cyrusbuilt/ESPStat/README.md

# ESPStat
ESP8266-controlled thermostat for Heat Pumps
