cyrusbuilt/ESPStat/schematics/ESPStat_bom.html

Label | Part Type | Properties
C1 | Ceramic Capacitor | voltage 6.3V; package 100 mil [THT, multilayer]; capacitance 0.1mF
C2 | Ceramic Capacitor | voltage 6.3V; package 100 mil [THT, multilayer]; capacitance 100nF
DHT1 | DHT22 Humidity and Temperature Sensor
Huzzah ESP8266 | Adafruit HUZZAH ESP8266 | variant variant 2; part # Adafruit #2471
IC1 | ULN2803A | package THT; variant ULN2803A
IC2 | MCP23017 I2C I/O Expander | variant PDIP
J1 | Screw terminal - 6 pins | hole size 1.0mm,0.508mm; package THT; pin spacing 0.137in (3.5mm); pins 6
J2 | Screw terminal - 2 pins | hole size 1.0mm,0.508mm; package THT; pin spacing 0.137in (3.5mm); pins 2
J3 | Generic male header - 3 pins | hole size 1.0mm,0.508mm; row single; package THT; pin spacing 0.1in (2.54mm); pins 3; form ♂ (male)
J4 | Generic male header - 6 pins | hole size 1.0mm,0.508mm; row single; package THT; pin spacing 0.1in (2.54mm); pins 6; form ♂ (male)
LED1 | Green (570nm) LED | package 5 mm [THT]; color Green (570nm); leg yes
LED2 | Green (570nm) LED | package 3 mm [THT]; color Green (570nm); leg yes
LED3 | Green (570nm) LED | package 3 mm [THT]; color Green (570nm); leg yes
LED4 | Green (570nm) LED | package 3 mm [THT]; color Green (570nm); leg yes
LED5 | Green (570nm) LED | package 3 mm [THT]; color Green (570nm); leg yes
LED6 | Red (633nm) LED | package 5 mm [THT]; color Red (633nm); leg yes
LED7 | Red (633nm) LED | package 5 mm [THT]; color Red (633nm); leg yes
LED8 | Red (633nm) LED | package 5 mm [THT]; color Red (633nm); leg yes
LED9 | Yellow (595nm) LED | package 5 mm [THT]; color Yellow (595nm); leg yes
M1 | RioRand LM2596 | chip label lm2596; variant variant 2
Part2 | Schematic Frame | filename ESPStat.fzz; rev 1.0; descr ESP8266-base IoT smart thermostat for heat pumps; sheet 1/1; date 1612884402; project ESPStat
R1 | 10kΩ Resistor | tolerance ±5%; resistance 10kΩ; package THT; bands 4; pin spacing 400 mil
R2 | 150Ω Resistor | tolerance ±5%; resistance 150Ω; package THT; bands 4; pin spacing 400 mil
R3 | 4.7kΩ Resistor | tolerance ±5%; resistance 4.7kΩ; package THT; bands 4; pin spacing 400 mil
REL1 | RELAY | package relay-jzc; variant pth4
REL2 | RELAY | package relay-jzc; variant pth4
REL3 | RELAY | package relay-jzc; variant pth4
REL4 | RELAY | package relay-jzc; variant pth4
Amount | Part Type | Properties
1 | Ceramic Capacitor | voltage 6.3V; package 100 mil [THT, multilayer]; capacitance 0.1mF
1 | Ceramic Capacitor | voltage 6.3V; package 100 mil [THT, multilayer]; capacitance 100nF
1 | DHT22 Humidity and Temperature Sensor
1 | Adafruit HUZZAH ESP8266 | variant variant 2; part # Adafruit #2471
1 | ULN2803A | package THT; variant ULN2803A
1 | MCP23017 I2C I/O Expander | variant PDIP
1 | Screw terminal - 6 pins | hole size 1.0mm,0.508mm; package THT; pin spacing 0.137in (3.5mm); pins 6
1 | Screw terminal - 2 pins | hole size 1.0mm,0.508mm; package THT; pin spacing 0.137in (3.5mm); pins 2
1 | Generic male header - 3 pins | hole size 1.0mm,0.508mm; row single; package THT; pin spacing 0.1in (2.54mm); pins 3; form ♂ (male)
1 | Generic male header - 6 pins | hole size 1.0mm,0.508mm; row single; package THT; pin spacing 0.1in (2.54mm); pins 6; form ♂ (male)
1 | Green (570nm) LED | package 5 mm [THT]; color Green (570nm); leg yes
4 | Green (570nm) LED | package 3 mm [THT]; color Green (570nm); leg yes
3 | Red (633nm) LED | package 5 mm [THT]; color Red (633nm); leg yes
1 | Yellow (595nm) LED | package 5 mm [THT]; color Yellow (595nm); leg yes
1 | RioRand LM2596 | chip label lm2596; variant variant 2
1 | Schematic Frame | filename ESPStat.fzz; rev 1.0; descr ESP8266-base IoT smart thermostat for heat pumps; sheet 1/1; date 1612884402; project ESPStat
1 | 10kΩ Resistor | tolerance ±5%; resistance 10kΩ; package THT; bands 4; pin spacing 400 mil
1 | 150Ω Resistor | tolerance ±5%; resistance 150Ω; package THT; bands 4; pin spacing 400 mil
1 | 4.7kΩ Resistor | tolerance ±5%; resistance 4.7kΩ; package THT; bands 4; pin spacing 400 mil
4 | RELAY | package relay-jzc; variant pth4
