cyrusbuilt/ESPStat/schematics/ESPStat_bb.pdf

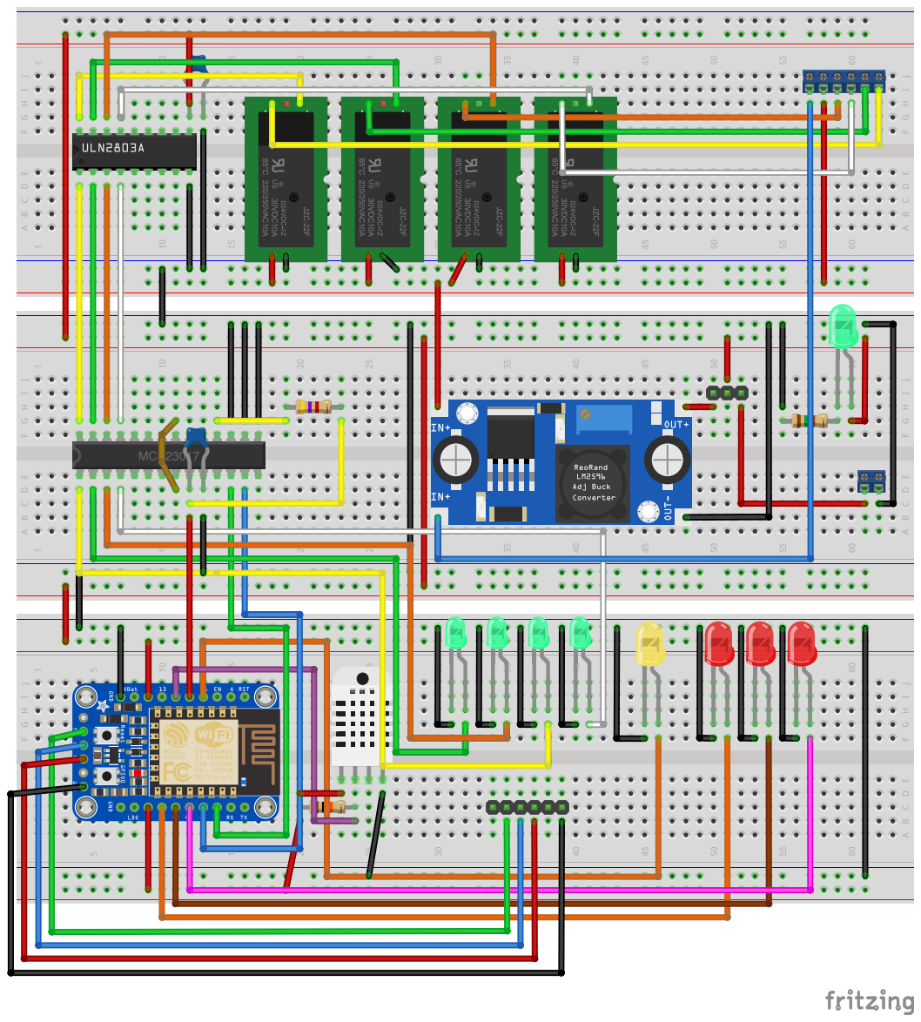
[picture p1: page 1]
