cyrusbuilt/ESPStat/schematics/ESPStat_pcb.pdf

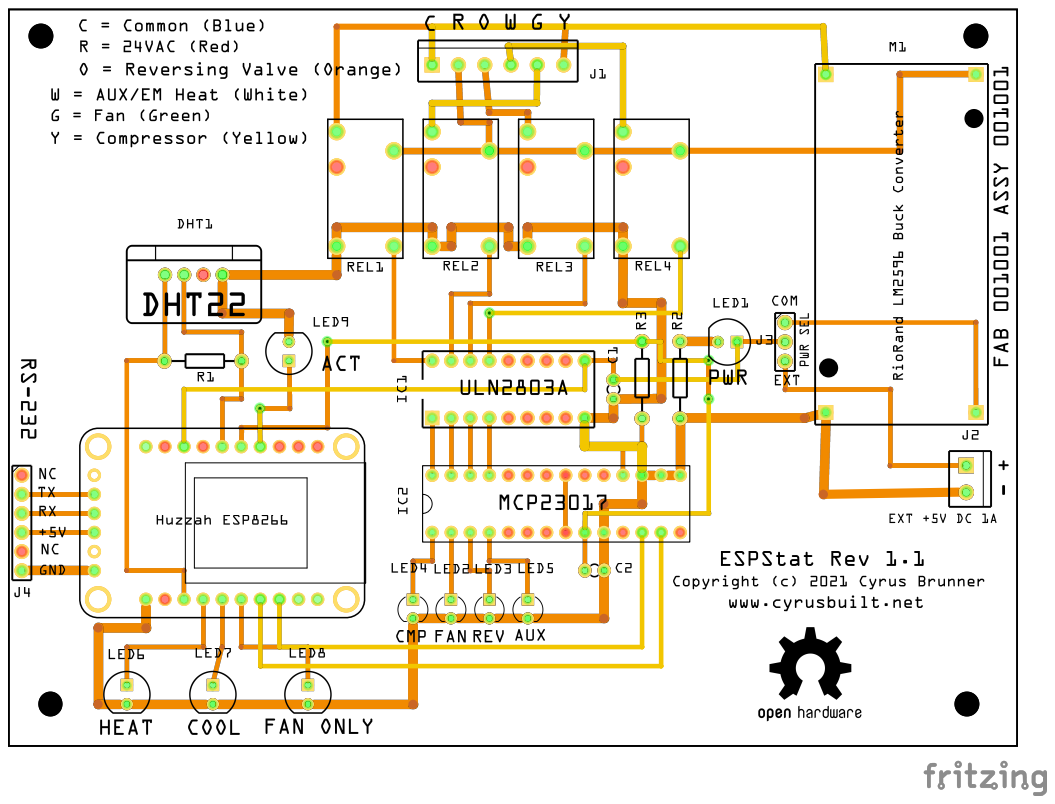
[picture p2: page 1]
