cyrusbuilt/ESPStat/schematics/ESPStat_schem.pdf

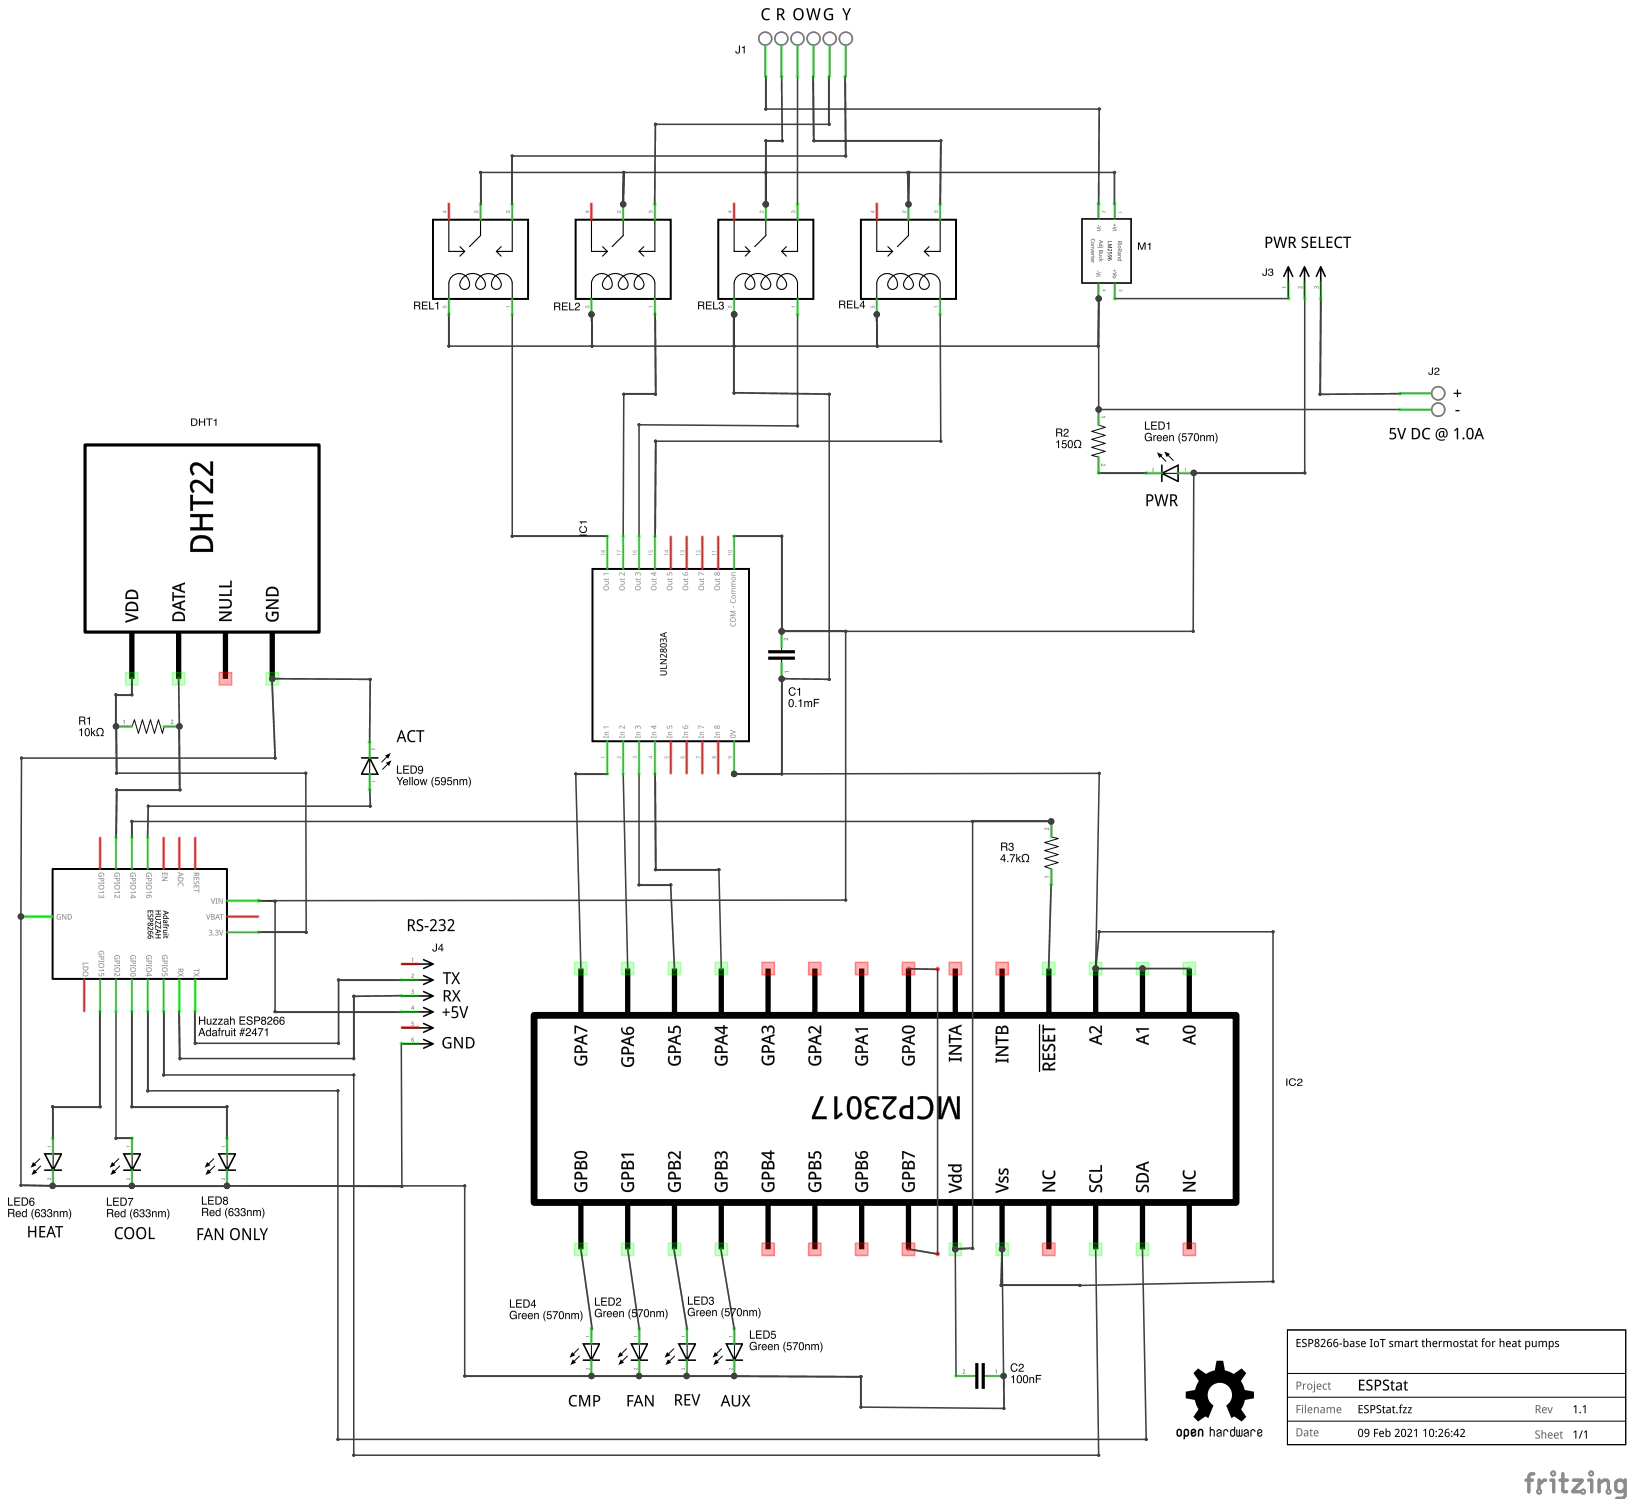
[picture p3: page 1]
