cyrusbuilt/ESPStat/(list of files, drawings)

Other design files:
schematics/ESPStat.fzz
