cyrusbuilt/ESPStat/src/main.cpp

#include <Arduino.h>
#include <ESP8266WiFi.h>
#include <FS.h>
#include <WiFiClient.h>
#include <Wire.h>
#include <time.h>
#include "Adafruit_MCP23017.h"
#include "ArduinoJson.h"
#include "Console.h"
#include "DHT.h"
#include "ESPCrashMonitor-master/ESPCrashMonitor.h"
#include "LED.h"
#include "HvacControl.h"
#include "PubSubClient.h"
#include "ResetManager.h"
#include "TaskScheduler.h"
#include "TelemetryHelper.h"
#include "config.h"

#define DEBUG

#define FIRMWARE_VERSION "1.0"
#define DHTTYPE DHT22            // DHT 22  (AM2302)
#define PRIMARY_I2C_ADDRESS 0
#define I2C_ADDRESS_OFFSET 32
#define READING_AVG_COUNT 2

// Pin definitions
#define PIN_LED_HEAT 15
#define PIN_LED_COOL 2
#define PIN_LED_FAN 0
#define PIN_LED_ACT 16
#define PIN_DHT22 12
#define PIN_IO_RESET 14

// Forward declarations
void onCheckWiFi();
void onCheckMqtt();
void failSafe();
void onMqttMessage(char* topic, byte* payload, unsigned int length);
void onSyncClock();
void readSensor();
void fanDelayStop();
void compressorDelayStart();
void hvacCycle();

// Global vars
#ifdef ENABLE_MDNS
    #include <ESP8266mDNS.h>
    MDNSResponder mdns;
#endif
WiFiClient wifiClient;
PubSubClient mqttClient(wifiClient);
DHT dht(PIN_DHT22, DHTTYPE);
LED ledHeat(PIN_LED_HEAT, NULL);
LED ledCool(PIN_LED_COOL, NULL);
LED ledFan(PIN_LED_FAN, NULL);
LED ledAct(PIN_LED_ACT, NULL);
Task tCheckWifi(CHECK_WIFI_INTERVAL, TASK_FOREVER, &onCheckWiFi);
Task tCheckMqtt(CHECK_MQTT_INTERVAL, TASK_FOREVER, &onCheckMqtt);
Task tSyncClock(CLOCK_SYNC_INTERVAL, TASK_FOREVER, &onSyncClock);
Task tReadSensors(TEMP_READ_INTERVAL, TASK_FOREVER, &readSensor);
Task tFanDelayStop(FAN_START_STOP_DELAY, TASK_ONCE, &fanDelayStop);
Task tCompressorStart(FAN_START_STOP_DELAY, TASK_ONCE, &compressorDelayStart);
Task tHvacCycle(HVAC_CYCLE_INTERVAL, TASK_FOREVER, &hvacCycle);
Scheduler taskMan;
Adafruit_MCP23017 bus;
config_t config;
bool filesystemMounted = false;
bool primaryExpanderFound = false;
uint8_t readCount = 0;
float humidity = 0;
float tempF = 0;
float tempC = 0;
float heatIndexC = 0;
float heatIndexF = 0;
float averageTemp = 0;
float sumOfReadings = 0;
unsigned long runStartTime = 0;
volatile bool isRunning = false;
volatile SystemState sysState = SystemState::BOOTING;

// **********************************
// Utility methods
// **********************************

void publishSystemState() {
	if (mqttClient.connected()) {
		ledAct.on();
		uint16_t freeMem = ESP.getMaxFreeBlockSize() - 512;

		DynamicJsonDocument doc(freeMem);
        doc["client_id"] = config.hostname;
        doc["systemState"] = (uint8_t)sysState;
        doc["firmwareVersion"] = FIRMWARE_VERSION;
		doc["humidity"] = humidity;
		doc["tempC"] = tempC;
		doc["tempF"] = tempF;
        doc["heatIndexC"] = heatIndexC;
        doc["heatIndexF"] = heatIndexF;
        doc["mode"] = (uint8_t)HvacControl.getMode();
        doc["tempAverageF"] = averageTemp;
        doc["isRunning"] = isRunning ? "ON" : "OFF";
        doc["auxHeat"] = HvacControl.isAuxHeatOn() ? "ON" : "OFF";
        doc.shrinkToFit();

        String jsonStr;
        size_t len = serializeJson(doc, jsonStr);
        Serial.print(F("INFO: Publishing system state: "));
        Serial.println(jsonStr);
        if (!mqttClient.publish(config.mqttTopicStatus.c_str(), jsonStr.c_str(), len)) {
            Serial.println(F("ERROR: Failed to publish message."));
        }

        doc.clear();
        ledAct.off();
	}
}

void scanBusDevices() {
    byte error;
    byte address;
    int devices = 0;

    // NOTE: We can have a max of only (8) MCP23017 chips connected to the bus at a time.
    // This gives a range of addresses 0 - 7 (which really translates to 32 - 39).
    Serial.println(F("INFO: Beginning I2C bus scan ..."));
    for (address = 32; address < 40; address++) {
        Wire.beginTransmission(address);
        error = Wire.endTransmission();
        if (error == 0) {
            devices++;
            Serial.print(F("INFO: I2C device found at address 0x"));
            if (address < 16) {
                Serial.print(F("0"));
            }

            Serial.print(address, HEX);
            Serial.println(F("!"));
            uint8_t realAddress = address - I2C_ADDRESS_OFFSET;
            if (!primaryExpanderFound && realAddress == PRIMARY_I2C_ADDRESS) {
                primaryExpanderFound = true;
            }
            // TODO we may need this if we ever want to support expansion.
            // else {
            //     devicesFound.push_back(realAddress);
            // }
        }
        else if (error == 4) {
            Serial.print(F("ERROR: Unknown error at address 0x"));
            if (address < 16) {
                Serial.print(F("0"));
            }

            Serial.println(address, HEX);
        }
    }

    if (devices == 0) {
        Serial.println(F("ERROR: No devices found!"));
    }
    else {
        Serial.println(F("INFO: Scan complete."));
    }
}

void HCF() {
    Serial.println(F("ERROR: ******* SYSTEM HALTED *******"));
    Serial.flush();
    sysState = SystemState::DISABLED;
    while (true) {
        ESPCrashMonitor.iAmAlive();
        delay(10);
    }
}

void resetCommBus() {
    Serial.print(F("INFO: Resetting comm bus... "));
	digitalWrite(PIN_IO_RESET, LOW);
	delay(500);
	digitalWrite(PIN_IO_RESET, HIGH);
	Serial.println(F("DONE"));
}

void reboot() {
    Serial.println(F("INFO: Rebooting..."));
    Serial.flush();
    delay(1000);
    sysState = SystemState::DISABLED;
    publishSystemState();
    resetCommBus();
    ResetManager.softReset();
}

void printNetworkInfo() {
    Serial.print(F("INFO: Local IP: "));
    Serial.println(WiFi.localIP());
    Serial.print(F("INFO: Gateway: "));
    Serial.println(WiFi.gatewayIP());
    Serial.print(F("INFO: Subnet mask: "));
    Serial.println(WiFi.subnetMask());
    Serial.print(F("INFO: DNS server: "));
    Serial.println(WiFi.dnsIP());
    Serial.print(F("INFO: MAC address: "));
    Serial.println(WiFi.macAddress());
    #ifdef DEBUG
    WiFi.printDiag(Serial);
    #endif
}

void getAvailableNetworks() {
    ESPCrashMonitor.defer();
    Serial.println(F("INFO: Scanning WiFi networks..."));
    int numNetworks = WiFi.scanNetworks();
    for (int i = 0; i < numNetworks; i++) {
        Serial.print(F("ID: "));
        Serial.print(i);
        Serial.print(F("\tNetwork name: "));
        Serial.print(WiFi.SSID(i));
        Serial.print(F("\tSignal strength:"));
        Serial.println(WiFi.RSSI(i));
    }
    Serial.println(F("----------------------------------"));
}

void saveConfiguration() {
    Serial.print(F("INFO: Saving configuration to: "));
    Serial.print(CONFIG_FILE_PATH);
    Serial.println(F(" ... "));
    if (!filesystemMounted) {
        Serial.println(F("FAIL"));
        Serial.println(F("ERROR: Filesystem not mounted."));
        return;
    }

    File configFile = SPIFFS.open(CONFIG_FILE_PATH, "w");
    if (!configFile) {
        Serial.println(F("FAIL"));
        Serial.println(F("ERROR: Failed to open config file for writing."));
        return;
    }
    
    uint16_t freeMem = ESP.getMaxFreeBlockSize() - 512;

	DynamicJsonDocument doc(freeMem);
    doc["hostname"] = config.hostname;
    doc["useDHCP"] = config.useDhcp;
    doc["ip"] = config.ip.toString();
    doc["gateway"] = config.gw.toString();
    doc["subnetMask"] = config.sm.toString();
    doc["dnsServer"] = config.dns.toString();
    doc["wifiSSID"] = config.ssid;
    doc["wifiPassword"] = config.password;
    doc["mqttBroker"] = config.mqttBroker;
    doc["mqttPort"] = config.mqttPort;
    doc["mqttControlChannel"] = config.mqttTopicControl;
    doc["mqttStatusChannel"] = config.mqttTopicStatus;
    doc["mqttUsername"] = config.mqttUsername;
    doc["mqttPassword"] = config.mqttPassword;
    doc["mode"] = (uint8_t)config.currentMode;
    doc["setPoint"] = config.setPoint;
    #ifdef ENABLE_OTA
        doc["otaPort"] = config.otaPort;
        doc["otaPassword"] = config.otaPassword;
    #endif
    doc.shrinkToFit();

    serializeJsonPretty(doc, configFile);
    doc.clear();
    
    configFile.flush();
    configFile.close();
    Serial.println(F("DONE"));
}

void setConfigurationDefaults() {
    String chipId = String(ESP.getChipId(), HEX);
    String defHostname = String(DEFAULT_HOST_NAME) + "_" + chipId;

    config.hostname = defHostname;
    config.ip = defaultIp;
    config.mqttBroker = MQTT_BROKER;
    config.mqttPassword = "";
    config.mqttPort = MQTT_PORT;
    config.mqttTopicControl = MQTT_TOPIC_CONTROL;
    config.mqttTopicStatus = MQTT_TOPIC_STATUS;
    config.mqttUsername = "";
    config.password = DEFAULT_PASSWORD;
    config.sm = defaultSm;
    config.ssid = DEFAULT_SSID;
    config.useDhcp = false;
    config.clockTimezone = CLOCK_TIMEZONE;
    config.dns = defaultDns;
    config.gw = defaultGw;
    config.currentMode = HvacMode::OFF;
    config.setPoint = DEFAULT_SET_POINT;
    #ifdef ENABLE_OTA
        config.otaPassword = OTA_PASSWORD;
        config.otaPort = OTA_HOST_PORT;
    #endif
}

void printWarningAndContinue(const __FlashStringHelper *message) {
    Serial.println();
    Serial.println(message);
    Serial.print(F("INFO: Continuing... "));
}

void loadConfiguration() {
    memset(&config, 0, sizeof(config));

    Serial.print(F("INFO: Loading config file: "));
    Serial.print(CONFIG_FILE_PATH);
    Serial.print(F(" ... "));
    if (!filesystemMounted) {
        Serial.println(F("FAIL"));
        Serial.println(F("ERROR: Filesystem not mounted."));
        return;
    }

    if (!SPIFFS.exists(CONFIG_FILE_PATH)) {
        Serial.println(F("FAIL"));
        Serial.println(F("WARN: Config file does not exist. Creating with default config..."));
        saveConfiguration();
        return;
    }

    File configFile = SPIFFS.open(CONFIG_FILE_PATH, "r");
    if (!configFile) {
        Serial.println("FAIL");
        Serial.println(F("ERROR: Unable to open config file. Using default config."));
        return;
    }

    size_t size = configFile.size();
    uint16_t freeMem = ESP.getMaxFreeBlockSize() - 512;
    if (size > freeMem) {
        Serial.println(F("FAIL"));
        Serial.print(F("ERROR: Not enough free memory to load document. Size = "));
        Serial.print(size);
        Serial.print(F(", Free = "));
        Serial.println(freeMem);
        configFile.close();
        return;
    }

    DynamicJsonDocument doc(freeMem);
    DeserializationError error = deserializeJson(doc, configFile);
    if (error) {
        Serial.println(F("FAIL"));
        Serial.println(F("ERROR: Failed to parse config file to JSON. Using default config."));
        return;
    }

    doc.shrinkToFit();
    configFile.close();

    String chipId = String(ESP.getChipId(), HEX);
    String defHostname = String(DEFAULT_HOST_NAME) + "_" + chipId;

    config.hostname = doc.containsKey("hostname") ? doc["hostname"].as<String>() : defHostname;
    config.useDhcp = doc.containsKey("isDhcp") ? doc["isDhcp"].as<bool>() : false;
    
    if (doc.containsKey("ip")) {
        if (!config.ip.fromString(doc["ip"].as<String>())) {
            printWarningAndContinue(F("WARN: Invalid IP in configuration. Falling back to factory default."));
        }
    }
    else {
        config.ip = defaultIp;
    }

    if (doc.containsKey("gateway")) {
        if (!config.gw.fromString(doc["gateway"].as<String>())) {
            printWarningAndContinue(F("WARN: Invalid gateway in configuration. Falling back to factory default."));
        }
    }
    else {
        config.gw = defaultGw;
    }

    if (doc.containsKey("subnetmask")) {
        if (!config.sm.fromString(doc["subnetmask"].as<String>())) {
            printWarningAndContinue(F("WARN: Invalid subnet mask in configuration. Falling back to factory default."));
        }
    }
    else {
        config.sm = defaultSm;
    }

    if (doc.containsKey("dns")) {
        if (!config.dns.fromString(doc["dns"].as<String>())) {
            printWarningAndContinue(F("WARN: Invalid DNS IP in configuration. Falling back to factory default."));
        }
    }
    else {
        config.dns = defaultDns;
    }

    config.ssid = doc.containsKey("wifiSSID") ? doc["wifiSSID"].as<String>() : DEFAULT_SSID;
    config.password = doc.containsKey("wifiPassword") ? doc["wifiPassword"].as<String>() : DEFAULT_PASSWORD;
    config.mqttBroker = doc.containsKey("mqttBroker") ? doc["mqttBroker"].as<String>() : MQTT_BROKER;
    config.mqttPort = doc.containsKey("mqttPort") ? doc["mqttPort"].as<int>() : MQTT_PORT;
    config.mqttTopicControl = doc.containsKey("mqttControlChannel") ? doc["mqttControlChannel"].as<String>() : MQTT_TOPIC_CONTROL;
    config.mqttTopicStatus = doc.containsKey("mqttStatusChannel") ? doc["mqttStatusChannel"].as<String>() : MQTT_TOPIC_STATUS;
    config.mqttUsername = doc.containsKey("mqttUsername") ? doc["mqttUsername"].as<String>() : "";
    config.mqttPassword = doc.containsKey("mqttPassword") ? doc["mqttPassword"].as<String>() : "";
    config.currentMode = doc.containsKey("mode") ? (HvacMode)doc["mode"].as<uint8_t>() : HvacMode::OFF;
    config.setPoint = doc.containsKey("setPoint") ? doc["setPoint"].as<float>() : DEFAULT_SET_POINT;

    #ifdef ENABLE_OTA
        config.otaPort = doc.containsKey("otaPort") ? doc["otaPort"].as<uint16_t>() : MQTT_PORT;
        config.otaPassword = doc.containsKey("otaPassword") ? doc["otaPassword"].as<String>() : OTA_PASSWORD;
    #endif

    doc.clear();
    Serial.println(F("DONE"));
}

void resumeNormal() {
    Serial.println(F("INFO: Resuming normal operation..."));
    taskMan.enableAll();
    ledAct.off();
    sysState = SystemState::NORMAL;
    publishSystemState();
}

void doFactoryRestore() {
    Serial.println();
    Serial.println(F("Are you sure you wish restore to factory default? (Y/n)?"));
    Console.waitForUserInput();
    String str = Console.getInputString();
    if (str == "Y" || str == "y") {
        Serial.print(F("INFO: Clearing current config... "));
        if (filesystemMounted) {
            if (SPIFFS.remove(CONFIG_FILE_PATH)) {
                Serial.println(F("DONE"));
                Serial.print(F("INFO: Removed file: "));
                Serial.println(CONFIG_FILE_PATH);

                Serial.print(F("INFO: Rebooting in "));
                for (uint8_t i = 5; i >= 1; i--) {
                    Serial.print(i);
                    Serial.print(F(" "));
                    delay(1000);
                }

                reboot();
            }
            else {
                Serial.println(F("FAIL"));
                Serial.println(F("ERROR: Failed to delete configuration file."));
            }
        }
        else {
            Serial.println(F("FAIL"));
            Serial.println(F("ERROR: Fileystem not mounted."));
        }
    }

    Serial.println();
}

bool reconnectMqttClient() {
    if (!mqttClient.connected()) {
        ledAct.on();
        Serial.print(F("INFO: Attempting to establish MQTT connection to "));
        Serial.print(config.mqttBroker);
        Serial.print(F(" on port: "));
        Serial.print(config.mqttPort);
        Serial.println(F("..."));
        
        bool didConnect = false;
        if (config.mqttUsername.length() > 0 && config.mqttPassword.length() > 0) {
            didConnect = mqttClient.connect(config.hostname.c_str(), config.mqttUsername.c_str(), config.mqttPassword.c_str());
        }
        else {
            didConnect = mqttClient.connect(config.hostname.c_str());
        }

        if (didConnect) {
            Serial.print(F("INFO: Subscribing to channel: "));
            Serial.println(config.mqttTopicControl);
            mqttClient.subscribe(config.mqttTopicControl.c_str());

            Serial.print(F("INFO: Publishing to channel: "));
            Serial.println(config.mqttTopicStatus);
        }
        else {
            String failReason = TelemetryHelper::getMqttStateDesc(mqttClient.state());
            Serial.print(F("ERROR: Failed to connect to MQTT broker: "));
            Serial.println(failReason);
            return false;
        }

        ledAct.off();
    }

    return true;
}

void connectWifi() {
    if (config.hostname) {
        WiFi.hostname(config.hostname);
    }

    #ifdef DEBUG
    Serial.println(F("DEBUG: Setting mode..."));
    #endif
    WiFi.mode(WIFI_STA);

    #ifdef DEBUG
    Serial.println(F("DEBUG: Disconnect and clear to prevent auto connect..."));
    #endif
    WiFi.persistent(false);
    WiFi.disconnect(true);
    ESPCrashMonitor.defer();

    delay(1000);
    if (config.useDhcp) {
        // If set to all zeros, then the SDK assumes DHCP.
        WiFi.config(0U, 0U, 0U, 0U);
    }
    else {
        // If actual IP set, then disables DHCP and assumes static.
        WiFi.config(config.ip, config.gw, config.sm, config.dns);
    }

    #ifdef DEBUG
    Serial.println(F("DEBUG: Beginning connection..."));
    #endif
    WiFi.begin(config.ssid, config.password);

    #ifdef DEBUG
    Serial.println(F("DEBUG: Waiting for connection..."));
    #endif
    
    const int maxTries = 20;
    int currentTry = 0;
    while ((WiFi.status() != WL_CONNECTED) && (currentTry < maxTries)) {
        ESPCrashMonitor.iAmAlive();
        currentTry++;
        ledAct.blink(500);
        delay(500);
    }

    if (WiFi.status() != WL_CONNECTED) {
        Serial.println(F("ERROR: Failed to connect to WiFi!"));
        failSafe();
    }
    else {
        printNetworkInfo();
    }
}

void failSafe() {
    ESPCrashMonitor.defer();
    Serial.println();
    Serial.println(F("ERROR: Entering failsafe (config) mode..."));

    // TODO Need to carefully consider this. Some tasks may need to stay running
    // so as not to damage the compressor.
    taskMan.disableAll();

    ledAct.on();
    sysState = SystemState::DISABLED;
    publishSystemState();
    Console.enterCommandInterpreter();
}

void readSensor() {
    if (config.setPoint > SETPOINT_MAX) {
        Serial.print(F("WARN: Setpoint above than max allowable. Adjusting to "));
        Serial.println(SETPOINT_MAX);
        config.setPoint = SETPOINT_MAX;
    }

    if (config.setPoint < SETPOINT_MIN) {
        Serial.print(F("WARN: Setpoint below minimum allowable. Adjusting to "));
        Serial.println(SETPOINT_MIN);
        config.setPoint = SETPOINT_MIN;
    }

	humidity = dht.readHumidity();
	tempC = dht.readTemperature();
	tempF = dht.convertCtoF(tempC);
	heatIndexC = dht.computeHeatIndex(false);
	heatIndexF = dht.computeHeatIndex();
    sumOfReadings += tempF;

    if (readCount >= READING_AVG_COUNT) {
        averageTemp = sumOfReadings / READING_AVG_COUNT;
        publishSystemState();
        sumOfReadings = 0;
        readCount = 0;
    }
    else {
        readCount++;
    }
}

bool isTempHysteresisMet() {
    return ((averageTemp - config.setPoint) > COMPRESSOR_HYSTERSIS
            || (config.setPoint - averageTemp) > COMPRESSOR_HYSTERSIS);
}

bool isShortCycle() {
    return (millis() - runStartTime) < COMPRESSOR_LOCKOUT_TIME;
}

void fanDelayStop() {
    if ((millis() - runStartTime) >= FAN_START_STOP_DELAY) {
        HvacControl.fanOff();
        isRunning = false;
        runStartTime = 0;
        publishSystemState();
        return;
    }

    tFanDelayStop.restart();
}

void compressorDelayStart() {
    HvacControl.compressorOn();
    HvacMode mode = HvacControl.getMode();
    if (mode == HvacMode::COOL) {
        HvacControl.reversingValveOn();
    }

    if (mode == HvacMode::HEAT && (config.setPoint - averageTemp) >= AUX_HEAT_HYSTERESIS) {
        HvacControl.auxHeatOn();
        publishSystemState();
    }
}

void hvacCycle() {
    HvacMode mode = HvacControl.getMode();
    if (mode == HvacMode::OFF && isRunning && !tFanDelayStop.isEnabled()) {
        Serial.println(F("INFO: Sytem still running. Shutting down air handler."));
        HvacControl.compressorOff();
        HvacControl.reversingValveOff();
        HvacControl.auxHeatOff();
        ledFan.off();
        ledCool.off();
        ledHeat.off();
        tFanDelayStop.restart();
    }
    else if (mode == HvacMode::FANONLY && !isRunning) {
        Serial.println(F("INFO: Starting blower fan..."));
        HvacControl.fanOn();
        ledFan.on();
        ledCool.off();
        ledHeat.off();
        tFanDelayStop.disable();
        isRunning = true;
        runStartTime = millis();
        publishSystemState();
    }
    else if (mode == HvacMode::COOL && !isRunning && isTempHysteresisMet() && !isShortCycle()) {
        Serial.println(F("INFO: Starting cooling cycle..."));
        isRunning = true;
        runStartTime = millis();
        ledCool.on();
        ledFan.off();
        ledHeat.off();
        HvacControl.fanOn();
        tCompressorStart.restart();
        publishSystemState();
    }
    else if (mode == HvacMode::HEAT && !isRunning && isTempHysteresisMet() && !isShortCycle()) {
        Serial.println(F("INFO: Starting heating cycle..."));
        isRunning = true;
        runStartTime = millis();
        ledHeat.on();
        ledFan.off();
        ledCool.off();
        HvacControl.fanOn();
        tCompressorStart.restart();
        publishSystemState();
    }
    else if (mode == HvacMode::COOL && isRunning && isTempHysteresisMet()) {
        Serial.println(F("INFO: Temperature hysteresis met. Ending cooling cycle..."));
        HvacControl.reversingValveOff();
        HvacControl.compressorOff();
        tFanDelayStop.restart();
    }
    else if (mode == HvacMode::HEAT && isRunning) {
        if ((config.setPoint - averageTemp) < AUX_HEAT_HYSTERESIS) {
            Serial.println(F("INFO: Aux/Em heat temperature hysteresis met. Shutting off Aux/Em heat..."));
            HvacControl.auxHeatOff();
            publishSystemState();
        }

        if (isTempHysteresisMet()) {
            Serial.println(F("INFO: Temperature hysteresis met. Ending heating cycle..."));
            HvacControl.compressorOff();
            tFanDelayStop.restart();
        }
    }
}

// **********************************
// Event handlers
// **********************************

void onSyncClock() {
    configTime(CLOCK_TIMEZONE * 3600, 0, "pool.ntp.org", "time.nist.gov");

    Serial.print(F("INIT: Waiting for NTP time sync..."));
    delay(500);
    while (!time(nullptr)) {
        ESPCrashMonitor.iAmAlive();
        Serial.print(F("."));
        delay(500);
    }

    time_t now = time(nullptr);
    struct tm *timeinfo = localtime(&now);

    Serial.println(F("DONE"));
    Serial.print(F("INFO: Current time: "));
    Serial.println(asctime(timeinfo));
}

void handleModeChange(HvacMode mode) {
	if (config.currentMode != mode) {
		Serial.print(F("INFO: Switched to HVAC mode: "));
		Serial.println(HvacControl.getModeDescription(mode));
        config.currentMode = mode;
	}
}

void handleControlRequest(ControlCommand command, HvacMode mode, float setpoint) {
    // When system is the "disabled" state, the only command it will accept
    // is "enable". All other commands are ignored.
    if (sysState == SystemState::DISABLED && command != ControlCommand::ENABLE) {
        // We can't process this command because we are disabled.
        Serial.print(F("WARN: Ignoring command "));
        Serial.print((uint8_t)command);
        Serial.print(F(" because the system is currently disabled."));
        return;
    }

    switch (command) {
        case ControlCommand::DISABLE:
            Serial.println(F("WARN: Disabling system."));
            sysState = SystemState::DISABLED;
            break;
        case ControlCommand::ENABLE:
            Serial.println(F("INFO: Enabling system."));
            sysState = SystemState::NORMAL;
            break;
        case ControlCommand::REBOOT:
            reboot();
            break;
        case ControlCommand::IO_RESET:
            resetCommBus();
            break;
        case ControlCommand::SET_MODE:
            HvacControl.setMode(config.currentMode);
            break;
        case ControlCommand::SET_TEMP:
            config.setPoint = setpoint;
            Serial.print(F("INFO: New temperature setpoint: "));
            Serial.println(config.setPoint);
            break;
        case ControlCommand::REQUEST_STATUS:
            break;
        default:
            Serial.print(F("WARN: Unknown command: "));
            Serial.println((uint8_t)command);
            break;
    }

    publishSystemState();
}

void onMqttMessage(char* topic, byte* payload, unsigned int length) {
    ledAct.on();
    Serial.print(F("INFO: [MQTT] Message arrived: ["));
    Serial.print(topic);
    Serial.print(F("] "));

    // It's a lot easier to deal with if we just convert the payload
    // to a string first.
    String msg;
    for (unsigned int i = 0; i < length; i++) {
        msg += (char)payload[i];
    }

    Serial.println(msg);

    StaticJsonDocument<200> doc;
    DeserializationError error = deserializeJson(doc, msg);
    if (error) {
        Serial.print(F("ERROR: Failed to parse MQTT message to JSON: "));
        Serial.println(error.c_str());
        doc.clear();
        return;
    }

    if (doc.containsKey("client_id")) {
        String id = doc["client_id"].as<String>();
        id.toUpperCase();
        if (!id.equals(config.hostname)) {
            Serial.println(F("INFO: Control message not intended for this host. Ignoring..."));
            doc.clear();
            return;
        }
    }
    else {
        Serial.println(F("WARN: MQTT message does not contain client ID. Ignoring..."));
        doc.clear();
        return;
    }

    if (!doc.containsKey("command")) {
        Serial.println(F("WARN: MQTT message does not contain a control command. Ignoring..."));
        doc.clear();
        return;
    }

    HvacMode mode = doc.containsKey("mode") ? (HvacMode)doc["mode"].as<uint8_t>() : config.currentMode;
    float setpoint = doc.containsKey("setPoint") ? doc["setPoint"].as<float>() : config.setPoint;
    ControlCommand cmd = (ControlCommand)doc["command"].as<uint8_t>();
    doc.clear();
    handleControlRequest(cmd, mode, setpoint);
}

void onCheckMqtt() {
    Serial.println(F("INFO: Checking MQTT connection status..."));
    if (reconnectMqttClient()) {
        Serial.println(F("INFO: Successfully reconnected to MQTT broker."));
        publishSystemState();
    }
    else {
        Serial.println(F("ERROR: MQTT connection lost and reconnect failed."));
        Serial.print(F("INFO: Retrying connection in "));
        Serial.print(CHECK_MQTT_INTERVAL % 1000);
        Serial.println(F(" seconds."));
    }
}

// **********************************
// Initialization routines
// **********************************

void initSerial() {
	#ifdef DEBUG
	const bool serialDebug = true;
	#else
	const bool serialDebug = false;
	#endif

	Serial.begin(SERIAL_BAUD);
	Serial.setDebugOutput(serialDebug);
	Serial.print(F("INIT: ESPStat v"));
	Serial.print(FIRMWARE_VERSION);
	Serial.println(F(" booting..."));
}

void initLeds() {
	Serial.print(F("INIT: Initializing inicators... "));
	ledCool.init();
	ledCool.on();
	ledFan.init();
	ledFan.on();
	ledHeat.init();
	ledHeat.on();
	ledAct.init();
	ledAct.on();
	Serial.println(F("DONE"));
}

void initCrashMonitor() {
    Serial.print(F("INIT: Initializing crash monitor... "));
    ESPCrashMonitor.disableWatchdog();
    Serial.println(F("DONE"));
    ESPCrashMonitor.dump(Serial);
    delay(100);
}

void initDhtSensor() {
	Serial.print(F("INIT: DHT22 sensor starting... "));
	dht.begin();
	Serial.println(F("DONE"));
}

void initComBus() {
    Serial.println(F("INIT: Initializing communication bus ..."));

	// ******* CRITICAL *******
    // We MUST drive the reset pin on the MCP23017 high or it will
    // not function. But, tying the reset pin to an output allows
    // us to programattically reset the I/O expander if needed.
	pinMode(PIN_IO_RESET, OUTPUT);
	digitalWrite(PIN_IO_RESET, HIGH);
	// ************************

	Wire.begin();
    scanBusDevices();
    if (primaryExpanderFound) {
        Serial.println(F("INFO: Found primary host bus controller. Enabling."));
        bus.begin((uint8_t)PRIMARY_I2C_ADDRESS);
    }
    else {
        Serial.println(F("ERROR: Primary host bus controller not found!!"));
        HCF();
    }

    Serial.println(F("INIT: Comm bus initialization complete."));
}

void initHvacControl() {
	Serial.print(F("INIT: HVAC Control starting... "));
	if (HvacControl.detect()) {
		HvacControl.begin(&bus);
		HvacControl.setModeChangeHandler(handleModeChange);
		Serial.println(F("DONE"));
		return;
	}

	Serial.println(F("FAIL"));
	Serial.println(F("ERROR: HVAC controller not detected!"));
}

void initFilesystem() {
    Serial.print(F("INIT: Initializing SPIFFS and mounting filesystem... "));
    if (!SPIFFS.begin()) {
        Serial.println(F("FAIL"));
        Serial.println(F("ERROR: Unable to mount filesystem."));
        return;
    }

    filesystemMounted = true;
    Serial.println(F("DONE"));
    loadConfiguration();
}

void initWiFi() {
    Serial.println(F("INIT: Initializing WiFi... "));
    getAvailableNetworks();
    
    Serial.print(F("INFO: Connecting to SSID: "));
    Serial.print(config.ssid);
    Serial.println(F("..."));
    
    connectWifi();
}

void initOTA() {
    #ifdef ENABLE_OTA
        Serial.print(F("INIT: Starting OTA updater... "));
        if (WiFi.status() == WL_CONNECTED) {
            ArduinoOTA.setPort(config.otaPort);
            ArduinoOTA.setHostname(config.hostname.c_str());
            ArduinoOTA.setPassword(config.otaPassword.c_str());
            ArduinoOTA.onStart([]() {
                sysState = SystemState::UPDATING;
                // Handles start of OTA update. Determines update type.
                String type;
                if (ArduinoOTA.getCommand() == U_FLASH) {
                    type = "sketch";
                }
                else {
                    type = "filesystem";
                }
                Serial.println("INFO: Starting OTA update (type: " + type + ") ...");
            });
            ArduinoOTA.onEnd([]() {
                // Handles update completion.
                Serial.println(F("INFO: OTA updater finished."));
            });
            ArduinoOTA.onProgress([](unsigned int progress, unsigned int total) {
                // Reports update progress.
                ESPCrashMonitor.iAmAlive();
                Serial.printf("INFO: OTA Update Progress: %u%%\r", (progress / (total / 100)));
            });
            ArduinoOTA.onError([](ota_error_t error) {
                // Handles OTA update errors.
                Serial.printf("ERROR: OTA update error [%u]: ", error);
                switch(error) {
                    case OTA_AUTH_ERROR:
                        Serial.println(F("Auth failed."));
                        break;
                    case OTA_BEGIN_ERROR:
                        Serial.println(F("Begin failed."));
                        break;
                    case OTA_CONNECT_ERROR:
                        Serial.println(F("Connect failed."));
                        break;
                    case OTA_RECEIVE_ERROR:
                        Serial.println(F("Receive failed."));
                        break;
                    case OTA_END_ERROR:
                        Serial.println(F("End failed."));
                        break;
                }
            });

            #ifdef ENABLE_MDNS
                const bool useMDNS = true;
            #else
                const bool useMDNS = false;
            #endif

            ArduinoOTA.begin(useMDNS);
            Serial.println(F("DONE"));
        }
        else {
            Serial.println(F("FAIL"));
        }
    #endif
}

void initMDNS() {
    #ifdef ENABLE_MDNS
        Serial.print(F("INIT: Starting MDNS responder... "));
        if (WiFi.status() == WL_CONNECTED) {
            ESPCrashMonitor.defer();
            delay(500);
            if (!mdns.begin(config.hostname)) {
                Serial.println(F(" FAILED"));
                return;
            }
            
            #ifdef ENABLE_OTA
                mdns.addService(config.hostname, "ota", config.otaPort);
            #endif
            Serial.println(F(" DONE"));
        }
        else {
            Serial.println(F(" FAILED"));
        }
    #endif
}

void initMQTT() {
    Serial.print(F("INIT: Initializing MQTT client... "));
    mqttClient.setBufferSize(256);
    mqttClient.setKeepAlive(45);
    mqttClient.setServer(config.mqttBroker.c_str(), config.mqttPort);
    mqttClient.setCallback(onMqttMessage);
    Serial.println(F("DONE"));
    if (reconnectMqttClient()) {
        delay(500);
        publishSystemState();
    }
}

void initTaskManager() {
    Serial.print(F("INIT: Initializing task scheduler... "));

    taskMan.init();
    taskMan.addTask(tCheckWifi);
    taskMan.addTask(tCheckMqtt);
    taskMan.addTask(tSyncClock);
    taskMan.addTask(tReadSensors);
    taskMan.addTask(tHvacCycle);
    
    tCheckWifi.enableDelayed(30000);
    tCheckMqtt.enableDelayed(1000);
    tSyncClock.enable();
    tReadSensors.enable();
    tHvacCycle.enable();
    Serial.println(F("DONE"));
}

// **********************************
// Console handlers
// **********************************

void handleNewHostname(const char* newHostname) {
    config.hostname = newHostname;
    if (config.hostname) {
        WiFi.hostname(config.hostname);
    }

    initMDNS();
}

void handleSwitchToDhcp() {
    if (config.useDhcp) {
        Serial.println(F("INFO: DHCP mode already set. Skipping..."));
        Serial.println();
    }
    else {
        config.useDhcp = true;
        Serial.println(F("INFO: Set DHCP mode."));
        WiFi.config(0U, 0U, 0U, 0U);
    }
}

void handleSwitchToStatic(IPAddress newIp, IPAddress newSm, IPAddress newGw, IPAddress newDns) {
    config.ip = newIp;
    config.sm = newSm;
    config.gw = newGw;
    config.dns = newDns;
    Serial.println(F("INFO: Set static network config."));
    WiFi.config(config.ip, config.gw, config.sm, config.dns);
}

void handleReconnectFromConsole() {
    // Attempt to reconnect to WiFi.
    onCheckWiFi();
    if (WiFi.status() == WL_CONNECTED) {
        printNetworkInfo();
        resumeNormal();
    }
    else {
        Serial.println(F("ERROR: Still no network connection."));
        Console.enterCommandInterpreter();
    }
}

void handleWifiConfig(String newSsid, String newPassword) {
    config.ssid = newSsid;
    config.password = newPassword;
    connectWifi();
}

void handleSaveConfig() {
    saveConfiguration();
    WiFi.disconnect(true);
    onCheckWiFi();
}

void handleMqttConfigCommand(String newBroker, int newPort, String newUsername, String newPassw, String newConChan, String newStatChan) {
    mqttClient.unsubscribe(config.mqttTopicControl.c_str());
    mqttClient.disconnect();

    config.mqttBroker = newBroker;
    config.mqttPort = newPort;
    config.mqttUsername = newUsername;
    config.mqttPassword = newPassw;
    config.mqttTopicControl = newConChan;
    config.mqttTopicStatus = newStatChan;

    initMQTT();
    Serial.println();
}

void handleBusResetCommand() {
    resetCommBus();
    initComBus();
    initHvacControl();
}

void handleModeSelection(uint8_t selection) {
    handleModeChange((HvacMode)selection);
}

void initConsole() {
    Serial.print(F("INIT: Initializing console... "));

    Console.setHostname(config.hostname);
    Console.setMqttConfig(
        config.mqttBroker,
        config.mqttPort,
        config.mqttUsername,
        config.mqttPassword,
        config.mqttTopicControl,
        config.mqttTopicStatus
    );
    Console.onRebootCommand(reboot);
    Console.onScanNetworks(getAvailableNetworks);
    Console.onFactoryRestore(doFactoryRestore);
    Console.onHostnameChange(handleNewHostname);
    Console.onDhcpConfig(handleSwitchToDhcp);
    Console.onStaticConfig(handleSwitchToStatic);
    Console.onReconnectCommand(handleReconnectFromConsole);
    Console.onWifiConfigCommand(handleWifiConfig);
    Console.onSaveConfigCommand(handleSaveConfig);
    Console.onMqttConfigCommand(handleMqttConfigCommand);
    Console.onConsoleInterrupt(failSafe);
    Console.onResumeCommand(resumeNormal);
    Console.onGetNetInfoCommand(printNetworkInfo);
    Console.onBusReset(handleBusResetCommand);
    Console.onSetMode(handleModeSelection);

    Serial.println(F("DONE"));
}

void onCheckWiFi() {
    Serial.println(F("INFO: Checking WiFi connectivity..."));
    if (WiFi.status() != WL_CONNECTED) {
        Serial.println(F("WARN: Lost connection. Attempting reconnect..."));
        connectWifi();
        if (WiFi.status() == WL_CONNECTED) {
            initMDNS();
            initOTA();
            initMQTT();
        }
    }
}

// **********************************
// Main routines
// **********************************

void setup() {
	initSerial();
	initLeds();
    initCrashMonitor();
	initDhtSensor();
    initComBus();
	initHvacControl();
    initFilesystem();
    initWiFi();
    initOTA();
    initMDNS();
    initMQTT();
    initTaskManager();
    initConsole();

    ledCool.off();
    ledFan.off();
    ledHeat.off();
    sysState = SystemState::NORMAL;
    Serial.println(F("INIT: Boot sequence complete."));
    ESPCrashMonitor.enableWatchdog(ESPCrashMonitorClass::ETimeout::Timeout_2s);
}

void loop() {
    ESPCrashMonitor.iAmAlive();
    Console.checkInterrupt();
    taskMan.execute();
    #ifdef ENABLE_MDNS
        mdns.update();
    #endif
    #ifdef ENABLE_OTA
        ArduinoOTA.handle();
    #endif
    mqttClient.loop();
}
