cyrusbuilt/ESPStat/(commit log)

2021-02-10 Initial commit of hardware design
    [ESPStat.fzz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]
2021-02-10 Fixup ground traces
    [ESPStat.fzz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]
2021-02-12 Adding act LED and firmware
    [ESPStat.fzz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]
2021-03-19 Fix external reset
    [ESPStat.fzz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]
